chbw/xlr-mute/xlr-mute.pdf

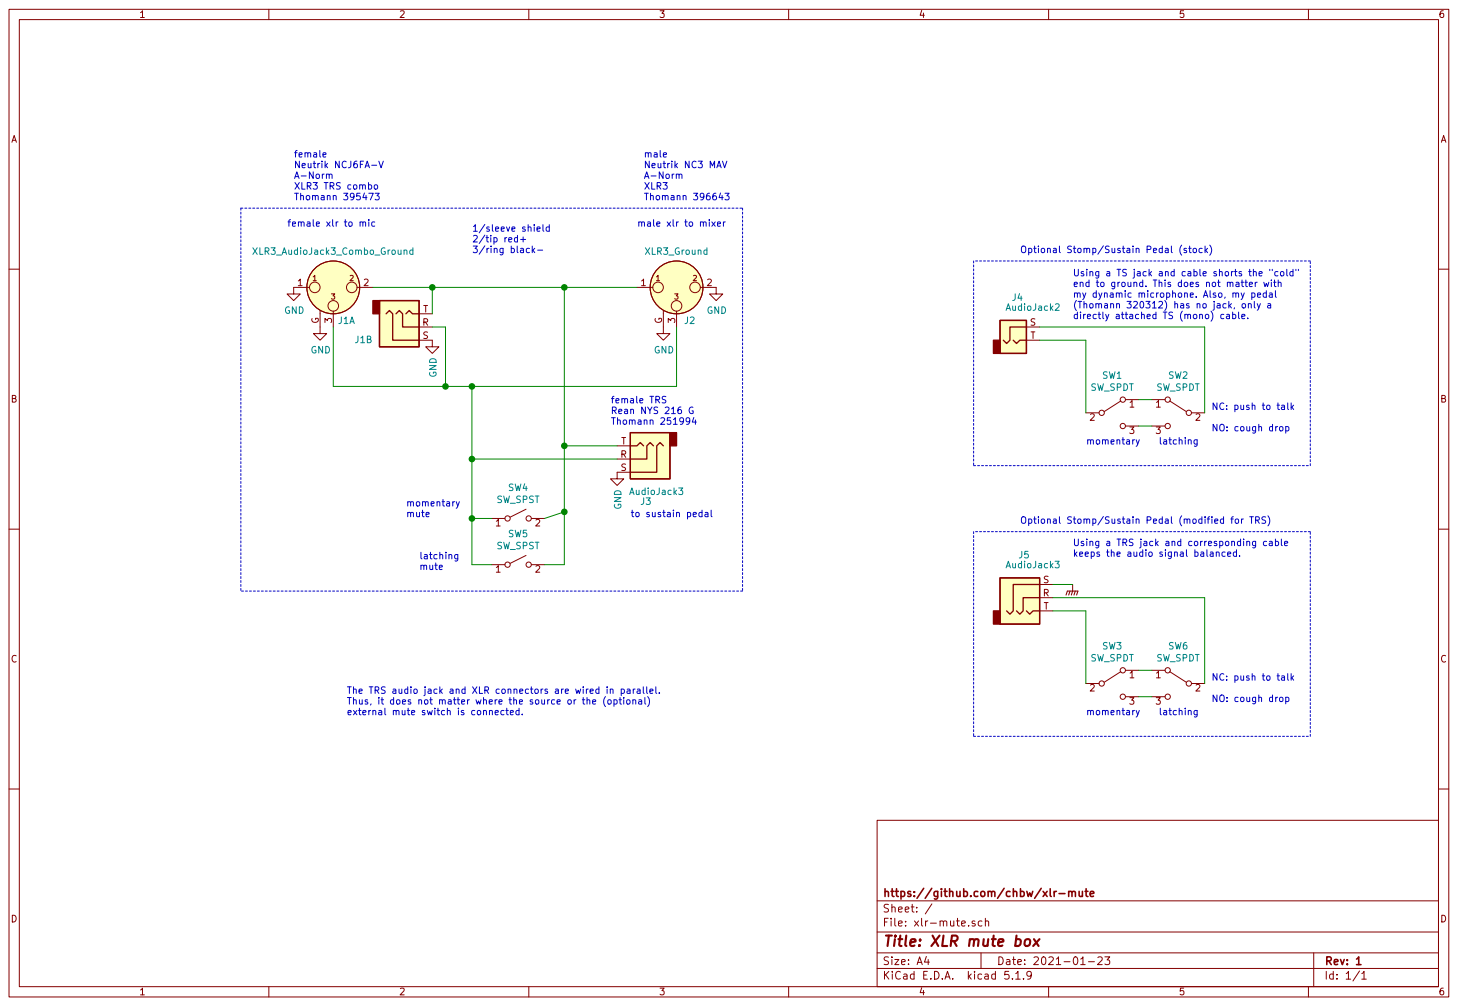
[picture p6: page 1]

Optional Stomp/Sustain Pedal (stock)

Using a TS jack and cable shorts the "cold"
end to ground. This does not matter with
my dynamic microphone. Also, my pedal
(Thomann 320312) has no jack, only a
directly attached TS (mono) cable.

female TRS Rean NYS 216 G

NC: push to talk
NO: cough drop

Optional Stomp/Sustain Pedal (modified for TRS)

Using a TRS jack and corresponding cable
keeps the audio signal balanced.

Thus, it does not matter where the source or the (optional) external mute switch is connected.

File: xlr-mute.sch Sheet: / https://github.com/chbw/xlr-mute

Id: 1/1 Title: XLR mute box
