chbw/xlr-mute/xlr-mute.sch

## KiCad design xlr-mute.sch (2021-01-24)

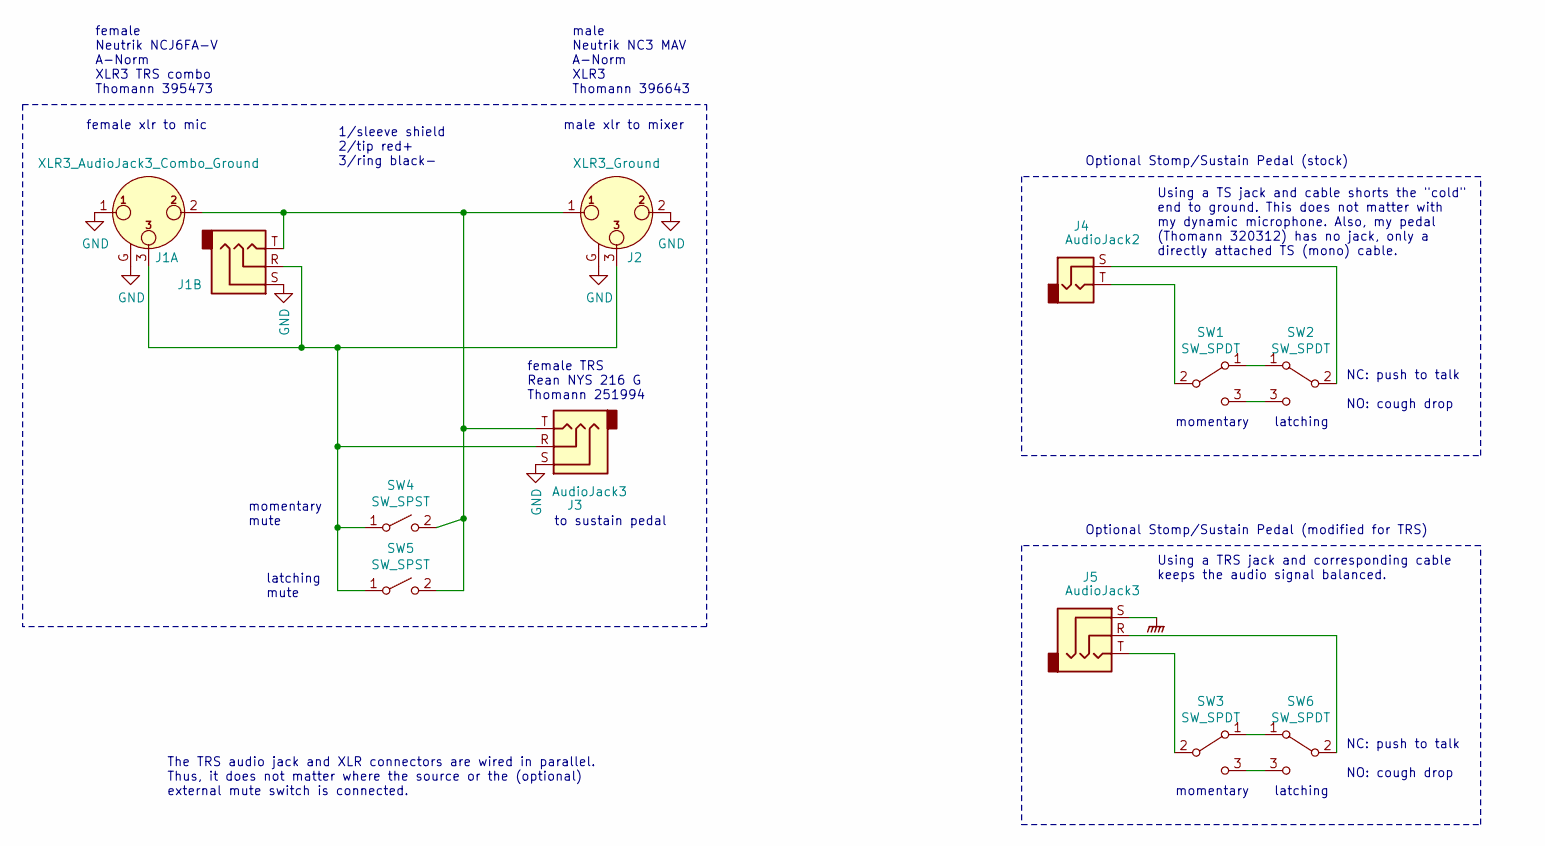
[picture p7: schematic xlr-mute.sch]

Parts:
J1: XLR3_AudioJack3_Combo_Ground
J2: XLR3_Ground
J3, J5: AudioJack3
J4: AudioJack2
SW1, SW2, SW3, SW6: SW_SPDT
SW4, SW5: SW_SPST

Connections:
GND: J1.1, J1.G, J1.S, J2.2, J2.G, J3.S
GNDPWR: J5.S
unnamed: J1.2, J1.T, J2.1, J3.T, SW4.2 (B), SW5.2 (B)
unnamed: J1.3, J1.R, J2.3, J3.R, SW4.1 (A), SW5.1 (A)
unnamed: J4.S, SW2.2 (B)
unnamed: J4.T, SW1.2 (B)
unnamed: J5.R, SW6.2 (B)
unnamed: J5.T, SW3.2 (B)
unnamed: SW1.1 (A), SW2.1 (A)
unnamed: SW1.3 (C), SW2.3 (C)
unnamed: SW3.1 (A), SW6.1 (A)
unnamed: SW3.3 (C), SW6.3 (C)

Notes on the sheet:
1/sleeve shield 2/tip red+ 3/ring black-
female xlr to mic
male xlr to mixer
momentary
latching
Optional Stomp/Sustain Pedal (stock)
NC: push to talk NO: cough drop
female Neutrik NCJ6FA-V A-Norm XLR3 TRS combo Thomann 395473
male Neutrik NC3 MAV A-Norm XLR3 Thomann 396643
female TRS Rean NYS 216 G Thomann 251994
momentary mute
latching mute
to sustain pedal
Optional Stomp/Sustain Pedal (modified for TRS)
The TRS audio jack and XLR connectors are wired in parallel. Thus, it does not matter where the source or the (optional) external mute switch is connected.
Using a TRS jack and corresponding cable keeps the audio signal balanced.
Using a TS jack and cable shorts the "cold" end to ground. This does not matter with my dynamic microphone. Also, my pedal (Thomann 320312) has no jack, only a directly attached TS (mono) cable.
